JoshRiang/4-WayCarRadarDetector/Documentation/2.jpeg

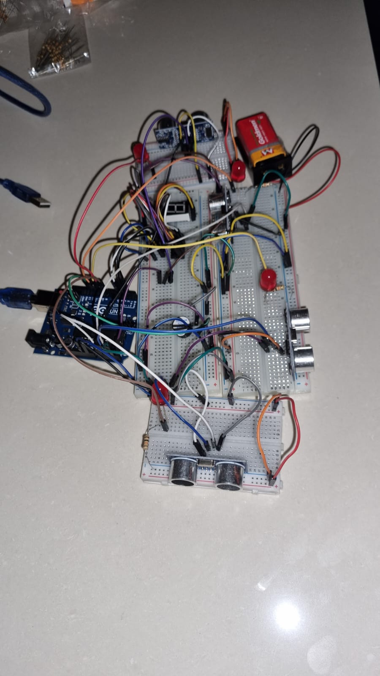
Documentation/2.jpeg
