JoshRiang/4-WayCarRadarDetector/Documentation/9.jpeg

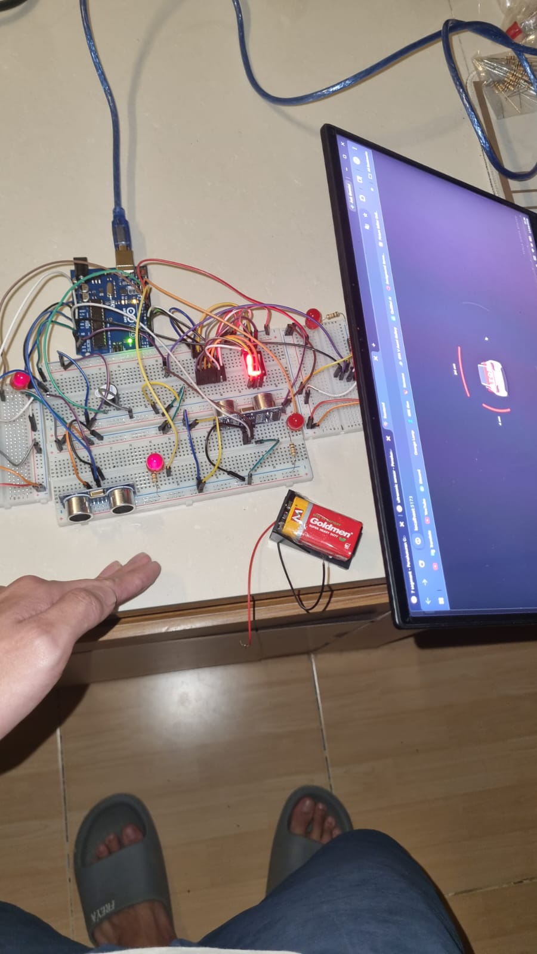
Documentation/9.jpeg
