JoshRiang/4-WayCarRadarDetector/Documentation/1.jpeg

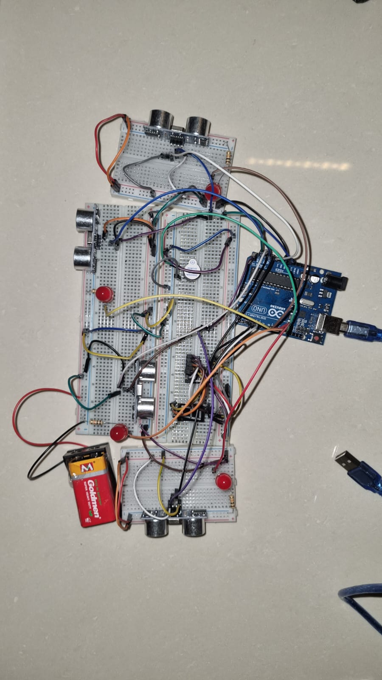
Documentation/1.jpeg
