JoshRiang/4-WayCarRadarDetector/Documentation/3.jpeg

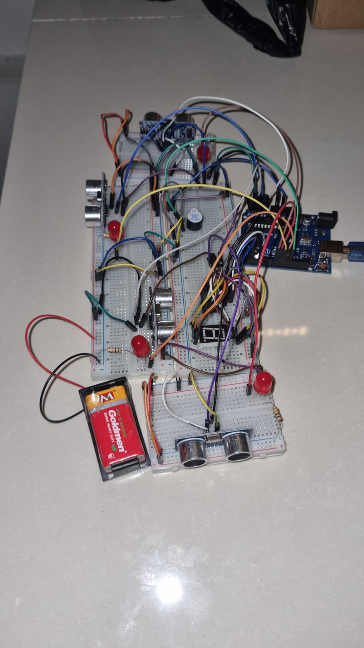
Documentation/3.jpeg
