JoshRiang/4-WayCarRadarDetector/Documentation/4.jpeg

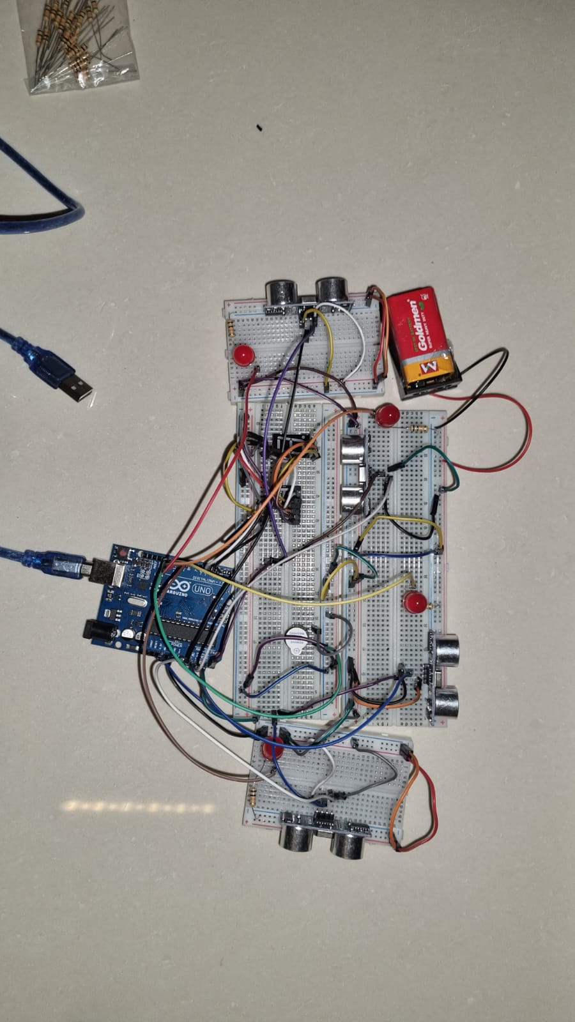
Documentation/4.jpeg
