JoshRiang/4-WayCarRadarDetector/Documentation/5.jpeg

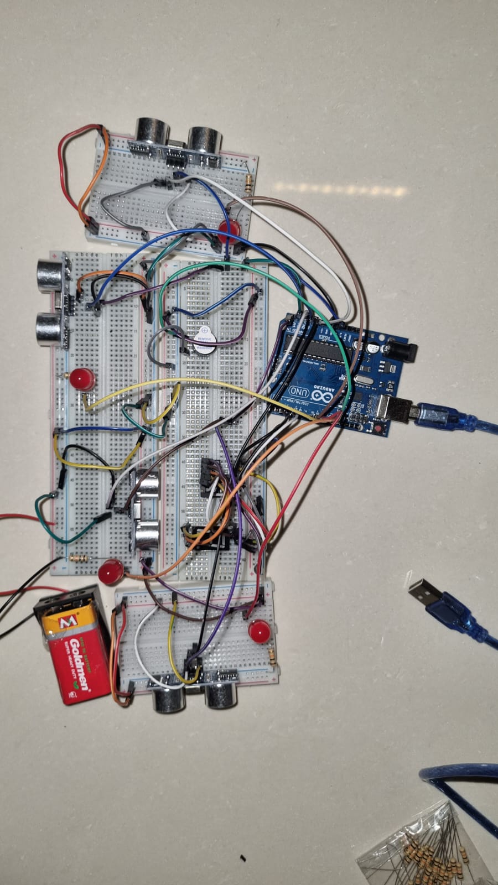
Documentation/5.jpeg
