JoshRiang/4-WayCarRadarDetector/Documentation/6.jpeg

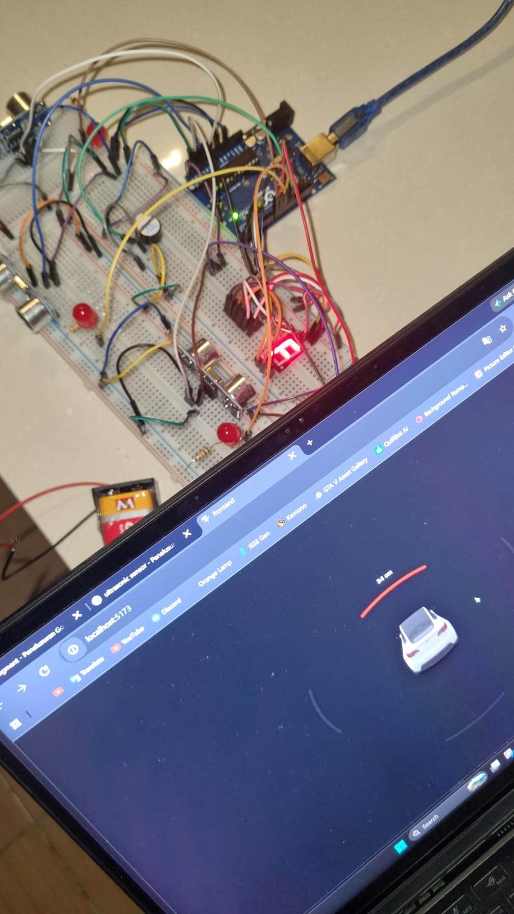
Documentation/6.jpeg
