JoshRiang/4-WayCarRadarDetector/Documentation/7.jpeg

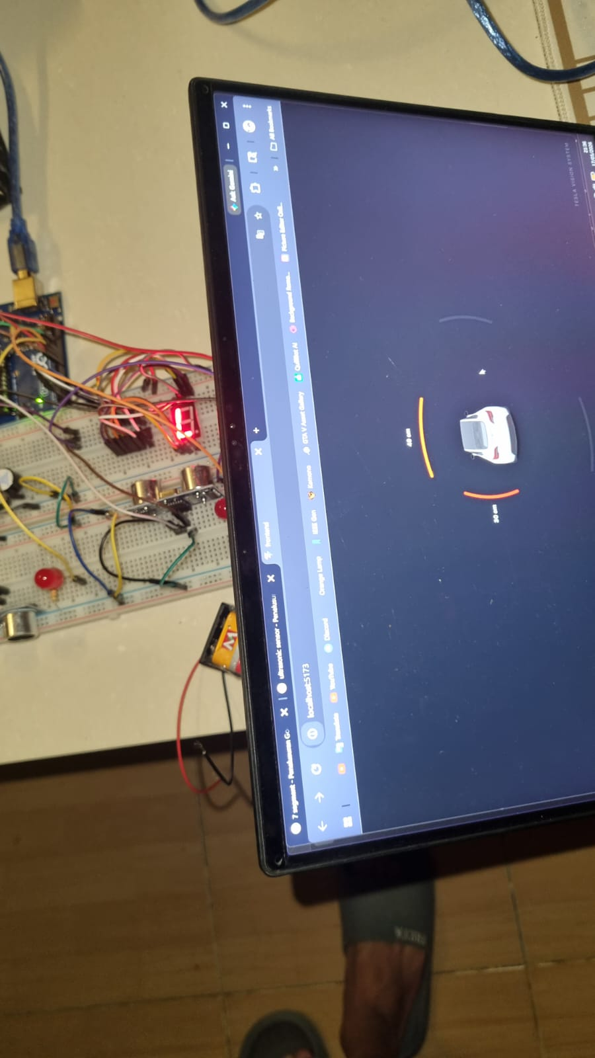
Documentation/7.jpeg
