JoshRiang/4-WayCarRadarDetector/Documentation/8.jpeg

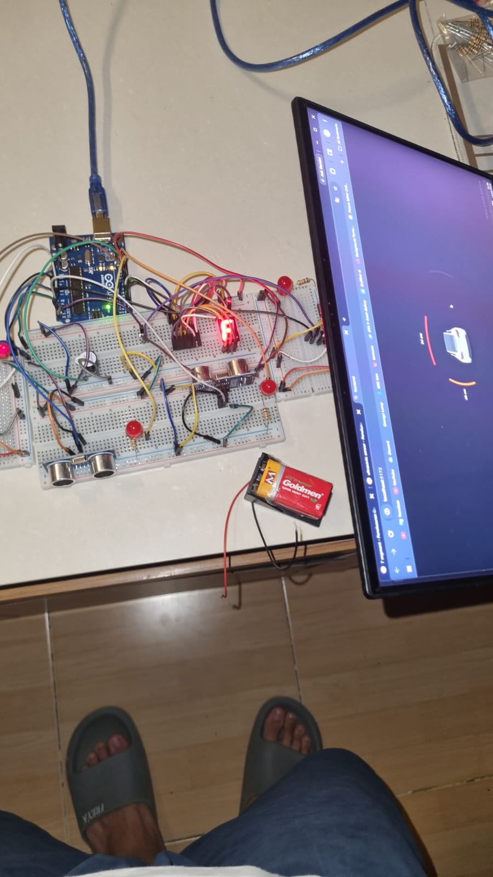
Documentation/8.jpeg
