JoshRiang/4-WayCarRadarDetector/Documentation/10.jpeg

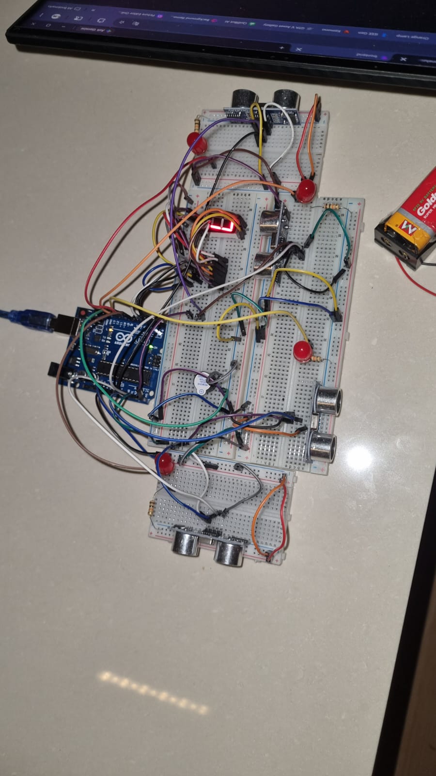
Documentation/10.jpeg
