JoshRiang/4-WayCarRadarDetector/Documentation/11.jpeg

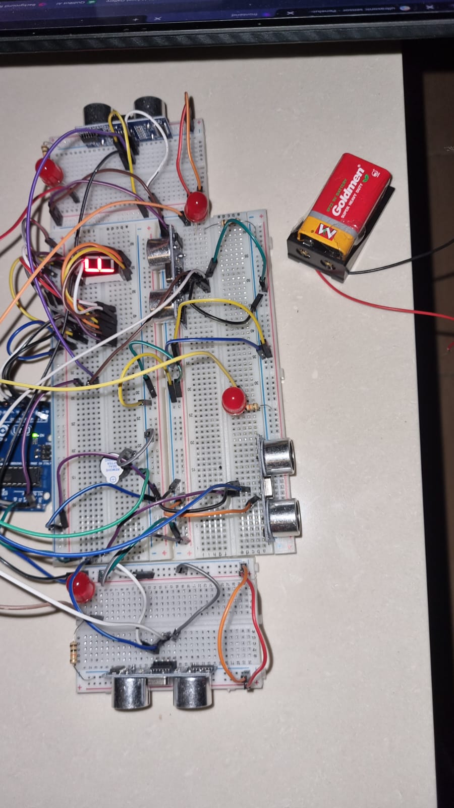
Documentation/11.jpeg
