JoshRiang/4-WayCarRadarDetector/(list of files, drawings)

Other design files:
Proteus Prototype.pdsprj
