JoshRiang/4-WayCarRadarDetector/(commit log)

2026-05-17 Adding prototype files
    [Proteus Prototype.pdsprj]
2026-05-17 Adding assembly code
